cb-repo/P031-KAKAPO-20A/assets/kakapo-left.jpg

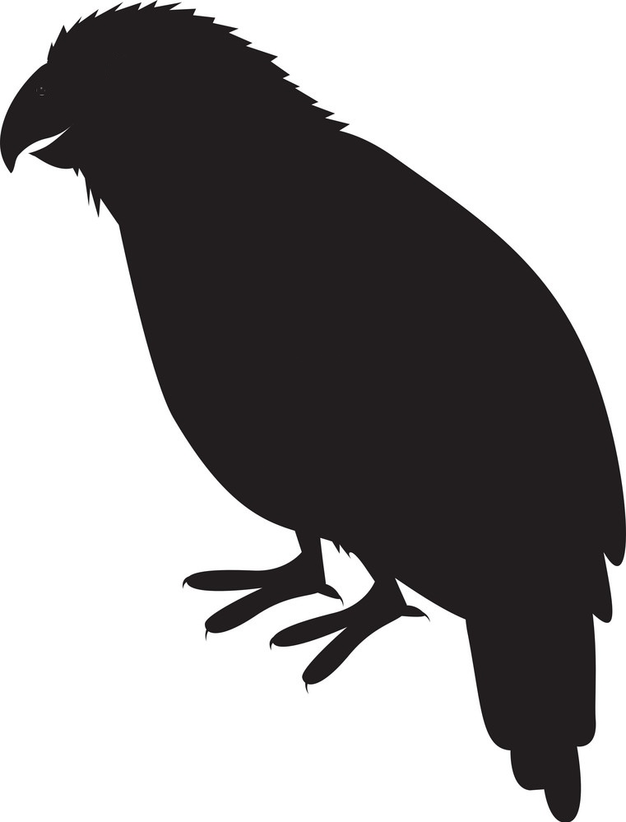
assets/kakapo-left.jpg
