cb-repo/P031-KAKAPO-20A/assets/kakapo-right.jpg

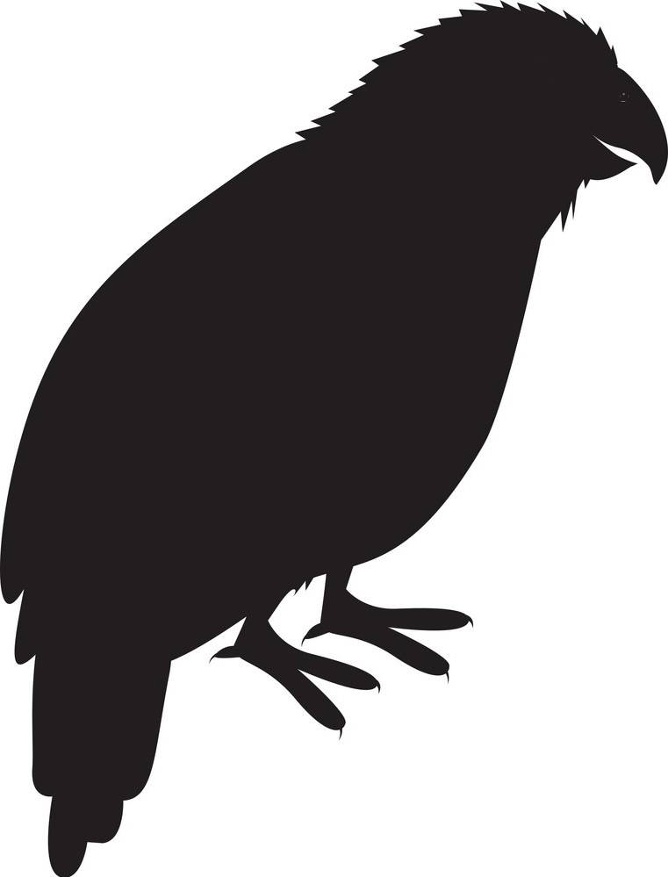
assets/kakapo-right.jpg
