cb-repo/P031-KAKAPO-20A/FIXTURE/KAKAPO-20A_FIXTURE.kicad_pcb

## KiCad design FIXTURE/KAKAPO-20A_FIXTURE.kicad_pcb (2025-01-29)

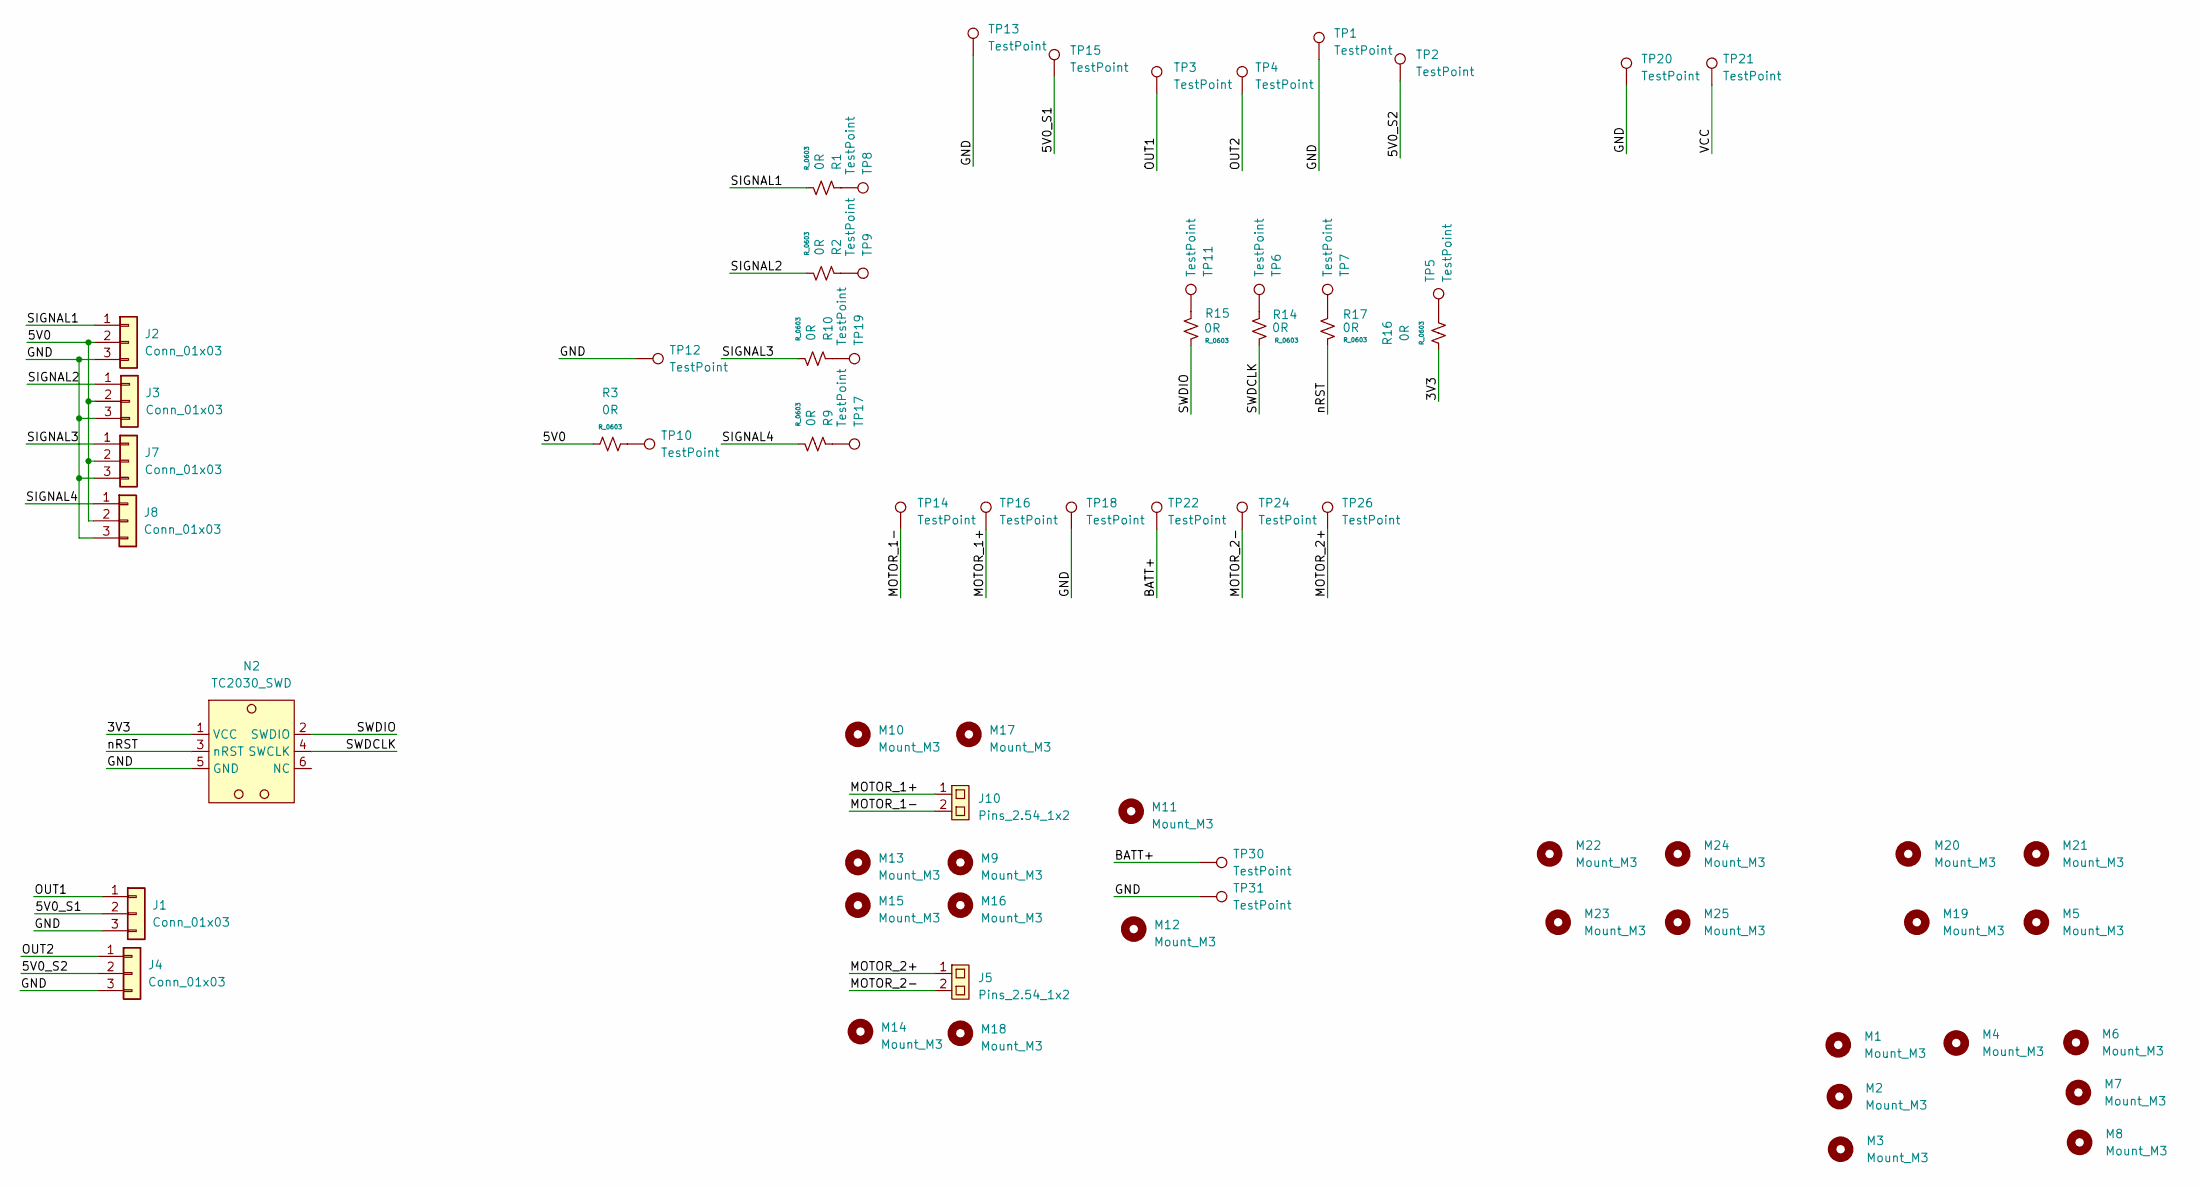
[picture p3: schematic KAKAPO-20A_FIXTURE.kicad_sch, KAKAPO - 20A FIXTURE]

Parts:
J1, J2, J3, J4, J7, J8: Conn_01x03; PinHeader_1x03_P2.54mm_Vertical
J5, J10: Pins_2.54_1x2; Pins-2.54-1x2
M1, M2, M3, M4, M5, M6, M7, M8, M9, M10, M11, M12, M13, M14, M15, M16, M17, M18, M19, M20, M21, M22, M23, M24, M25: Mount_M3
N2: TC2030_SWD; TagConnect_TC2030
R1, R2, R3, R9, R10, R14, R15, R16, R17: 0R; R_0603
TP1, TP2, TP3, TP4, TP5, TP6, TP7, TP8, TP9, TP10, TP11, TP12, TP13, TP14, TP15, TP16, TP17, TP18, TP19, TP20, TP21, TP22, TP24, TP26, TP30, TP31: TestPoint; TestPoint_THTPad_D3.0mm_Drill1.5mm

Connections:
/3V3: N2.1 (VCC), R16.1
/5V0: J2.2, J3.2, J7.2, J8.2, R3.1
/5V0_S1: J1.2, TP15.1
/5V0_S2: J4.2, TP2.1
/BATT+: TP22.1, TP30.1
/GND: J1.3, J2.3, J3.3, J4.3, J7.3, J8.3, N2.5 (GND), TP1.1, TP12.1, TP13.1, TP18.1, TP20.1, TP31.1
/MOTOR_1+: J10.1, TP16.1
/MOTOR_1-: J10.2, TP14.1
/MOTOR_2+: J5.1, TP26.1
/MOTOR_2-: J5.2, TP24.1
/OUT1: J1.1, TP3.1
/OUT2: J4.1, TP4.1
/SIGNAL1: J2.1, R1.2
/SIGNAL2: J3.1, R2.2
/SIGNAL3: J7.1, R10.2
/SIGNAL4: J8.1, R9.2
/SWDCLK: N2.4 (SWCLK), R14.2
/SWDIO: N2.2 (SWDIO), R15.2
/VCC: TP21.1
/nRST: N2.3 (nRST), R17.2
unnamed: R1.1, TP8.1
unnamed: R2.1, TP9.1
unnamed: R3.2, TP10.1
unnamed: R9.1, TP17.1
unnamed: R10.1, TP19.1
unnamed: R14.1, TP6.1
unnamed: R15.1, TP11.1
unnamed: R16.2, TP5.1
unnamed: R17.1, TP7.1

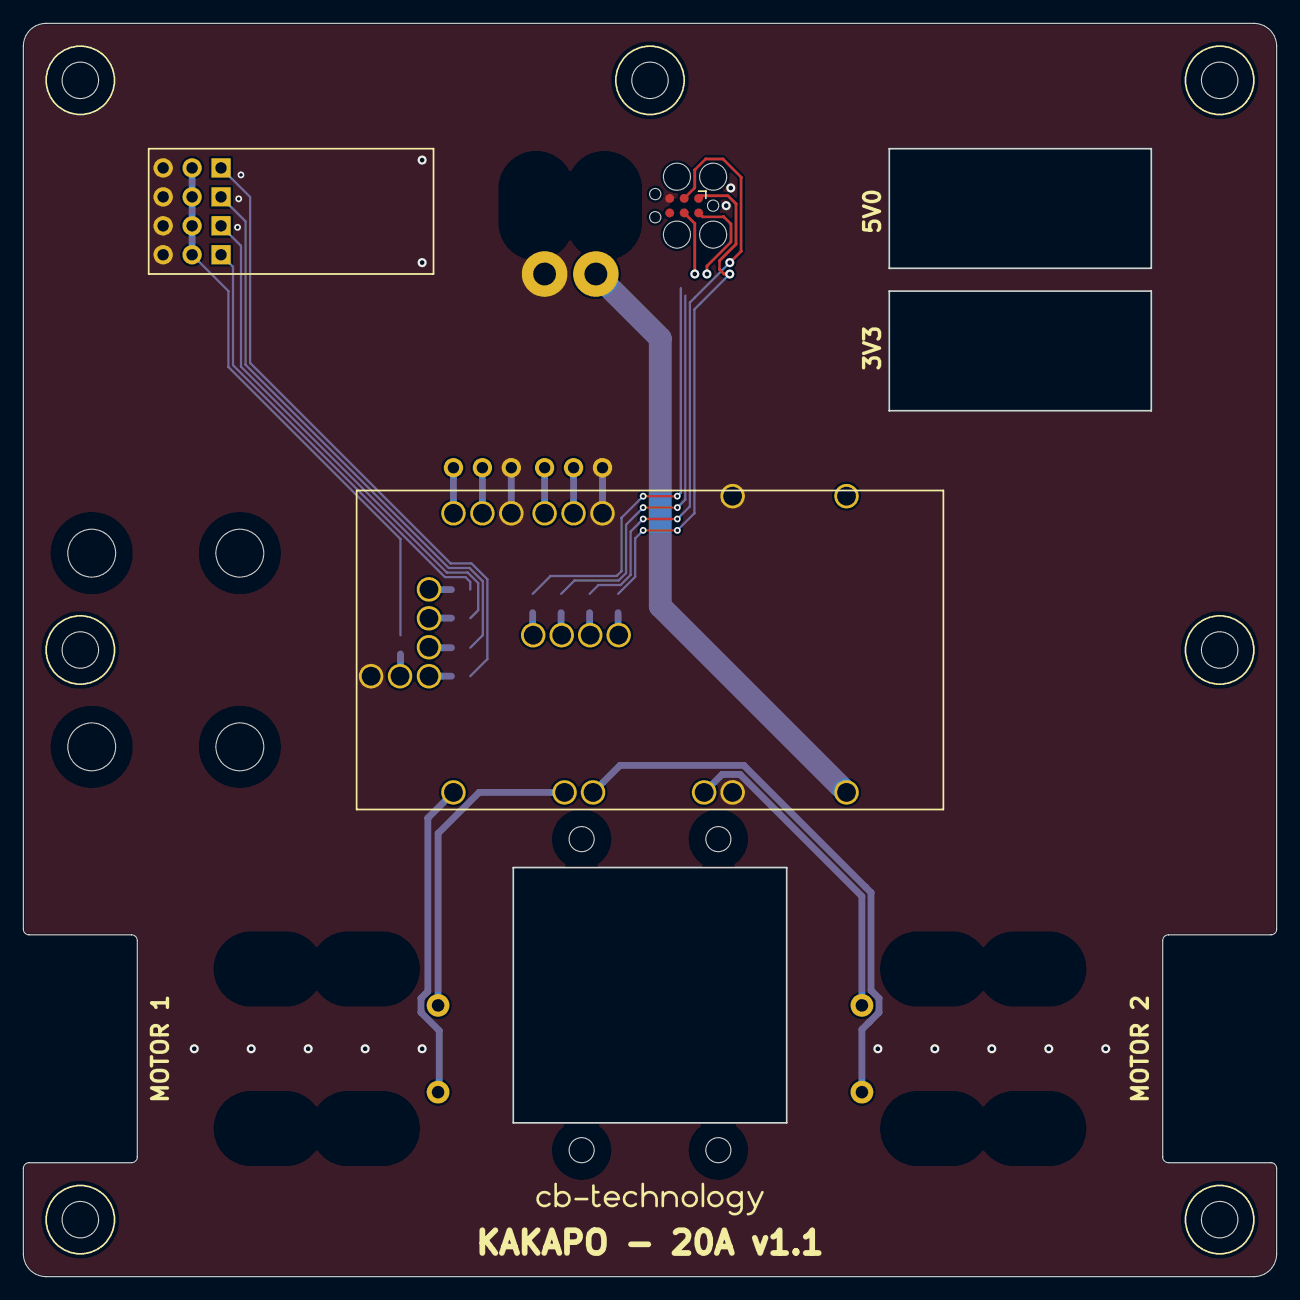
[picture p4: board KAKAPO-20A_FIXTURE.kicad_pcb from above]

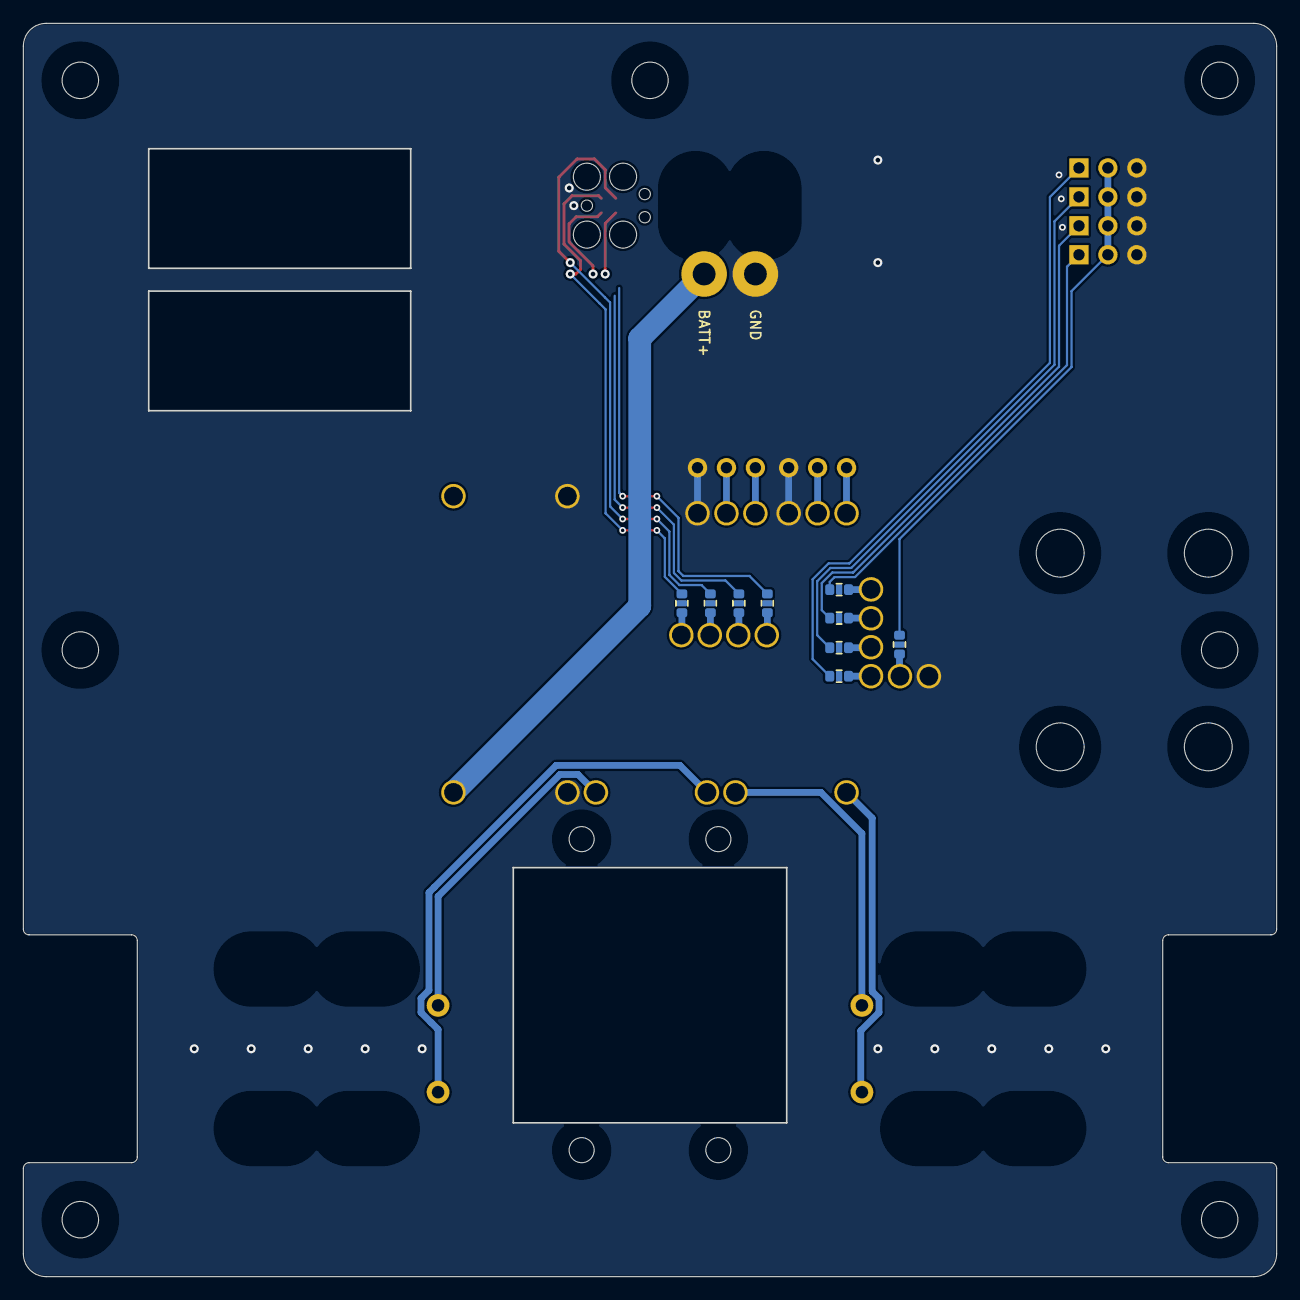
[picture p5: board KAKAPO-20A_FIXTURE.kicad_pcb from below]

Board: 2 copper layers, 110.0 x 110.0 mm, 69 parts (13 on the bottom side), 28 nets.
