cb-repo/P031-KAKAPO-20A/HW/KAKAPO-20A.kicad_pcb

## KiCad design HW/KAKAPO-20A.kicad_pcb (2024-07-17)

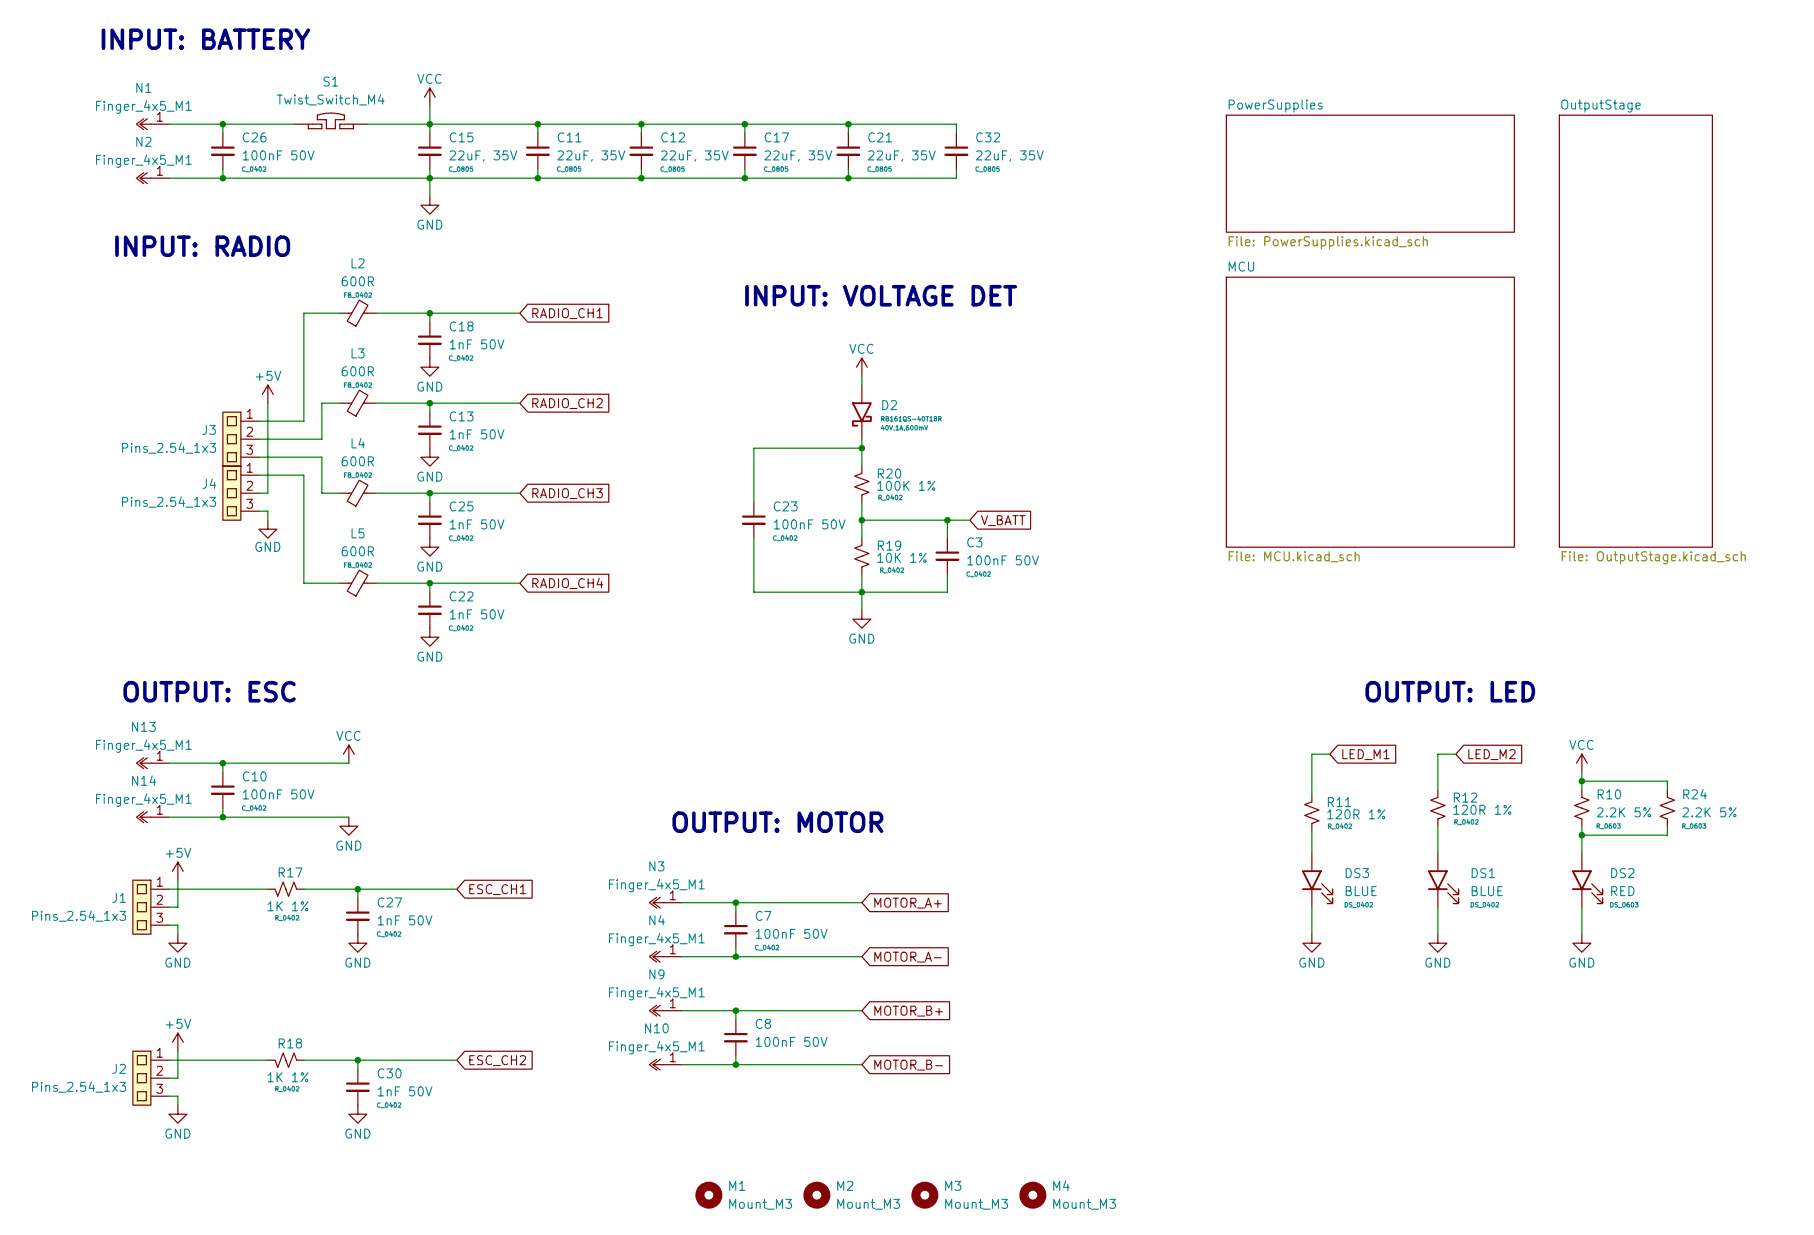
[picture p6: schematic KAKAPO-20A.kicad_sch, KAKAPO - 20A]

Parts:
C3, C7, C8, C10, C23, C26: 100nF 50V; C_0402; LCSC Part C105882
C11, C12, C15, C17, C21, C32: 22uF, 35V; C_0805; MFG Part HGC0805R5226M350NSLJ; LCSC Part C22367832
C13, C18, C22, C25, C27, C30: 1nF 50V; C_0402; LCSC Part C106205
D2: RB161QS-40T18R; R_0402; LCSC Part C2837790
DS1, DS3: BLUE; DS_0402; LCSC Part C965795
DS2: RED; DS_Everlight_IR21-21CL110TR8; MFG Part LTST-C230KRKT; LCSC Part C125107
J1, J2, J3, J4: Pins_2.54_1x3; Pins-2.54-1x3; LCSC Part C429954
L2, L3, L4, L5: 600R; FB_0402; MFG Part CBG100505U601T; LCSC Part C92618
M1, M2, M3, M4: Mount_M3
N1, N2, N3, N4, N9, N10, N13, N14: Finger_4x5_M1
R10, R24: 2.2K 5%; R_0603; MFG Part CRCW06032K20JNEAHP; LCSC Part C2077696
R11, R12: 120R 1%; R_0402; LCSC Part C114758
R17, R18: 1K 1%; R_0402; LCSC Part C2935237
R19: 10K 1%; R_0402; LCSC Part C60490
R20: 100K 1%; R_0402; LCSC Part C60491
S1: Twist_Switch_M4; MFG Part SMTSO4020MTJ; LCSC Part C2916373

Connections:
+5V: J1.2, J2.2, J4.2; also elsewhere on the board
ESC_CH1: C27.1, R17.2; also elsewhere on the board
ESC_CH2: C30.1, R18.2; also elsewhere on the board
GND: C3.2, C10.2, C11.2, C12.2, C13.2, C15.2, C17.2, C18.2, C21.2, C22.2, C23.2, C25.2, C26.2, C27.2, C30.2, C32.2, DS1.1 (K), DS2.1 (K), DS3.1 (K), J1.3, J2.3, J4.3, N2.1, N14.1, R19.2; also elsewhere on the board
LED_M1: R11.1; also elsewhere on the board
LED_M2: R12.1; also elsewhere on the board
MOTOR_A+: C7.1, N3.1; also elsewhere on the board
MOTOR_A-: C7.2, N4.1; also elsewhere on the board
MOTOR_B+: C8.1, N9.1; also elsewhere on the board
MOTOR_B-: C8.2, N10.1; also elsewhere on the board
unnamed: C23.1, D2.1, R20.1
unnamed: C26.1, N1.1, S1.2
unnamed: DS1.2 (A), R12.2
unnamed: DS2.2 (A), R10.2, R24.2
unnamed: DS3.2 (A), R11.2
unnamed: J1.1, R17.1
unnamed: J2.1, R18.1
unnamed: J3.1, L2.1
unnamed: J3.2, L3.1
unnamed: J3.3, L4.1
unnamed: J4.1, L5.1
RADIO_CH1: C18.1, L2.2; also elsewhere on the board
RADIO_CH2: C13.1, L3.2; also elsewhere on the board
RADIO_CH3: C25.1, L4.2; also elsewhere on the board
RADIO_CH4: C22.1, L5.2; also elsewhere on the board
VCC: C10.1, C11.1, C12.1, C15.1, C17.1, C21.1, C32.1, D2.2, N13.1, R10.1, R24.1, S1.1; also elsewhere on the board
V_BATT: C3.1, R19.1, R20.2; also elsewhere on the board

Notes on the sheet:
OUTPUT: MOTOR
OUTPUT: ESC
INPUT: RADIO
INPUT: VOLTAGE DET
OUTPUT: LED
INPUT: BATTERY

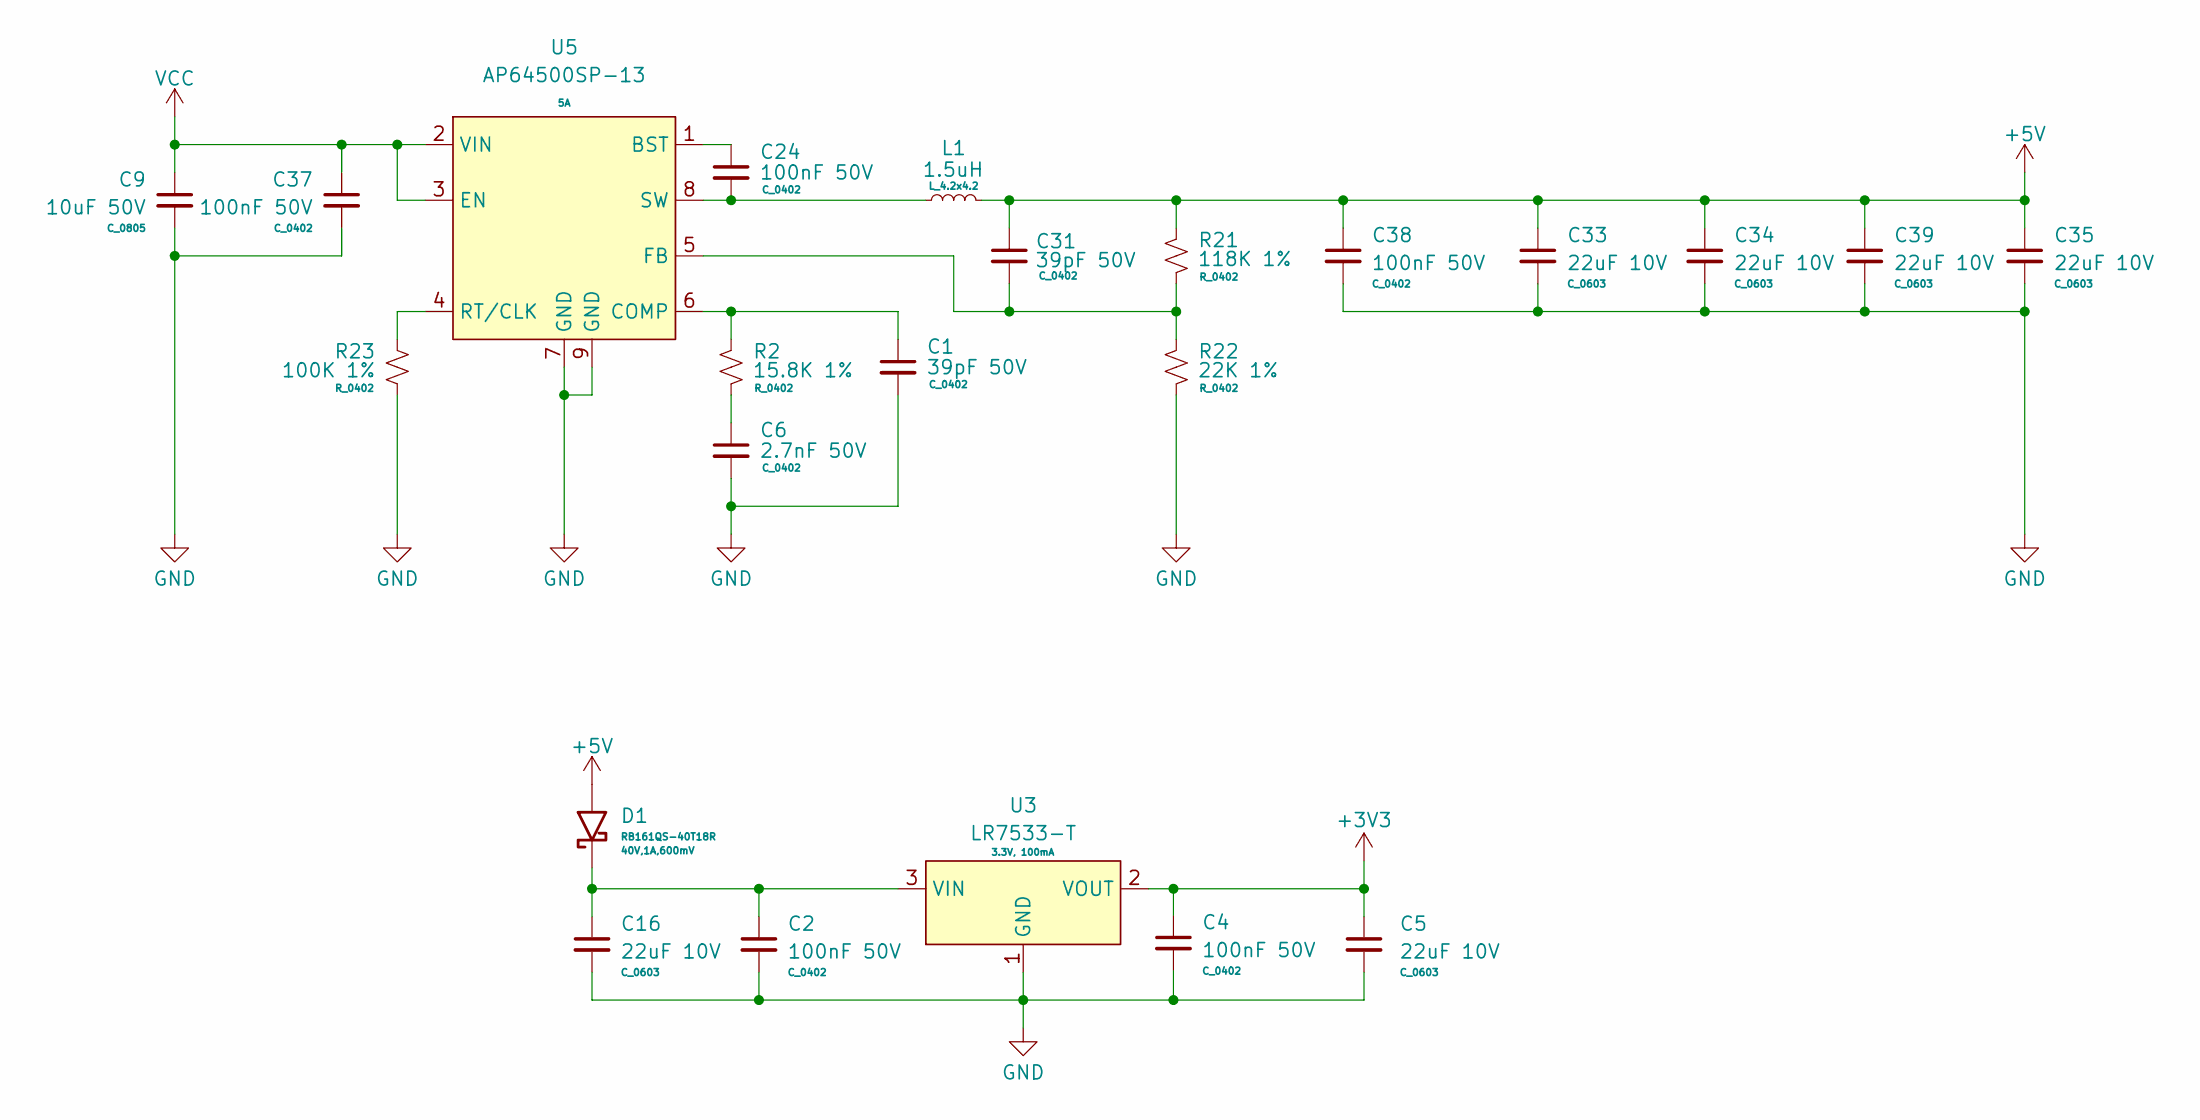
[picture p7: schematic PowerSupplies.kicad_sch, KAKAPO - 20A]

Parts:
C1, C31: 39pF 50V; C_0402; LCSC Part C106223
C2, C4, C24, C37, C38: 100nF 50V; C_0402; LCSC Part C105882
C5, C16, C33, C34, C35, C39: 22uF 10V; C_0603; LCSC Part C86295
C6: 2.7nF 50V; C_0402; LCSC Part C106251
C9: 10uF 50V; C_0805; MFG Part CL21A106KBYQNNE; LCSC Part C2932476
D1: RB161QS-40T18R; R_0402; LCSC Part C2837790
L1: 1.5uH; L_4.2x4.2; MFG Part BCIHP0420SC-1R5M; LCSC Part C2921165
R2: 15.8K 1%; R_0402; LCSC Part C26956
R21: 118K 1%; R_0402; LCSC Part C5126219
R22: 22K 1%; R_0402; LCSC Part C2909337
R23: 100K 1%; R_0402; LCSC Part C60491
U3: LR7533-T; SOT23_3; MFG Part LR7533-T; LCSC Part C486069
U5: AP64500SP-13; SOIC_8_EP; LCSC Part C2070920

Connections:
+3V3: C4.1, C5.1, U3.2 (VOUT); also elsewhere on the board
+5V: C31.1, C33.1, C34.1, C35.1, C38.1, C39.1, D1.2, L1.2, R21.1; also elsewhere on the board
GND: C1.2, C2.2, C4.2, C5.2, C6.2, C9.2, C16.2, C33.2, C34.2, C35.2, C37.2, C38.2, C39.2, R22.2, R23.2, U3.1 (GND), U5.7 (GND), U5.9 (GND); also elsewhere on the board
unnamed: C6.1, R2.2
unnamed: C2.1, C16.1, D1.1, U3.3 (VIN)
unnamed: C24.1, U5.1 (BST)
unnamed: C1.1, R2.1, U5.6 (COMP)
unnamed: C31.2, R21.2, R22.1, U5.5 (FB)
unnamed: R23.1, U5.4 (RT/CLK)
unnamed: C24.2, L1.1, U5.8 (SW)
VCC: C9.1, C37.1, U5.2 (VIN), U5.3 (EN); also elsewhere on the board

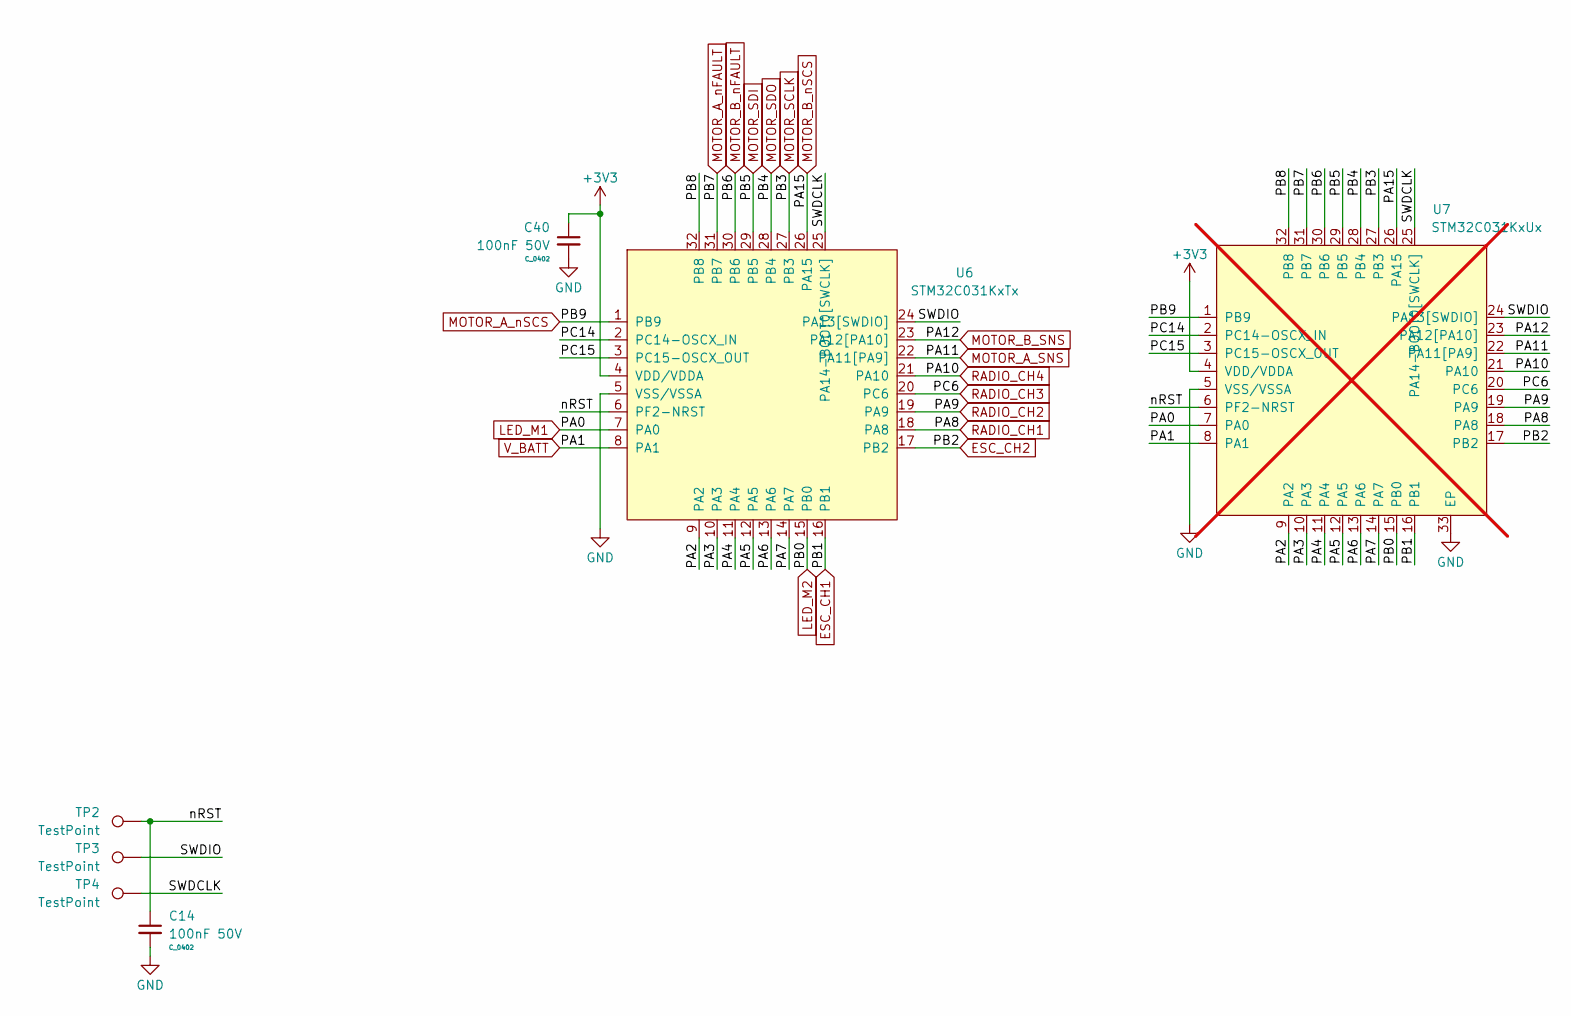
[picture p8: schematic MCU.kicad_sch, KAKAPO - 20A]

Parts:
C14, C40: 100nF 50V; C_0402; LCSC Part C105882
TP2, TP3, TP4: TestPoint; TestPoint_Pad_D1.5mm
U6: STM32C031KxTx; LQFP32_08_7x7
U7: STM32C031KxUx; QFN32_05_5x5_EP; not fitted

Connections:
+3V3: C40.1, U6.4 (VDD/VDDA), U7.4 (VDD/VDDA); also elsewhere on the board
/MCU/PA2: U6.9 (PA2), U7.9 (PA2)
/MCU/PA3: U6.10 (PA3), U7.10 (PA3)
/MCU/PA4: U6.11 (PA4), U7.11 (PA4)
/MCU/PA5: U6.12 (PA5), U7.12 (PA5)
/MCU/PA6: U6.13 (PA6), U7.13 (PA6)
/MCU/PA7: U6.14 (PA7), U7.14 (PA7)
/MCU/PB8: U6.32 (PB8), U7.32 (PB8)
/MCU/PC14: U6.2 (PC14-OSCX_IN), U7.2 (PC14-OSCX_IN)
/MCU/PC15: U6.3 (PC15-OSCX_OUT), U7.3 (PC15-OSCX_OUT)
/MCU/SWDCLK: TP4.1, U6.25 (PA14-BOOT0[SWCLK]), U7.25 (PA14-BOOT0[SWCLK])
/MCU/SWDIO: TP3.1, U6.24 (PA13[SWDIO]), U7.24 (PA13[SWDIO])
/MCU/nRST: C14.1, TP2.1, U6.6 (PF2-NRST), U7.6 (PF2-NRST)
ESC_CH1: U6.16 (PB1), U7.16 (PB1); also elsewhere on the board
ESC_CH2: U6.17 (PB2), U7.17 (PB2); also elsewhere on the board
GND: C14.2, C40.2, U6.5 (VSS/VSSA), U7.5 (VSS/VSSA), U7.33 (EP); also elsewhere on the board
LED_M1: U6.7 (PA0), U7.7 (PA0); also elsewhere on the board
LED_M2: U6.15 (PB0), U7.15 (PB0); also elsewhere on the board
MOTOR_A_SNS: U6.22 (PA11[PA9]), U7.22 (PA11[PA9]); also elsewhere on the board
MOTOR_A_nFAULT: U6.31 (PB7), U7.31 (PB7); also elsewhere on the board
MOTOR_A_nSCS: U6.1 (PB9), U7.1 (PB9); also elsewhere on the board
MOTOR_B_SNS: U6.23 (PA12[PA10]), U7.23 (PA12[PA10]); also elsewhere on the board
MOTOR_B_nFAULT: U6.30 (PB6), U7.30 (PB6); also elsewhere on the board
MOTOR_B_nSCS: U6.26 (PA15), U7.26 (PA15); also elsewhere on the board
MOTOR_SCLK: U6.27 (PB3), U7.27 (PB3); also elsewhere on the board
MOTOR_SDI: U6.29 (PB5), U7.29 (PB5); also elsewhere on the board
MOTOR_SDO: U6.28 (PB4), U7.28 (PB4); also elsewhere on the board
RADIO_CH1: U6.18 (PA8), U7.18 (PA8); also elsewhere on the board
RADIO_CH2: U6.19 (PA9), U7.19 (PA9); also elsewhere on the board
RADIO_CH3: U6.20 (PC6), U7.20 (PC6); also elsewhere on the board
RADIO_CH4: U6.21 (PA10), U7.21 (PA10); also elsewhere on the board
V_BATT: U6.8 (PA1), U7.8 (PA1); also elsewhere on the board

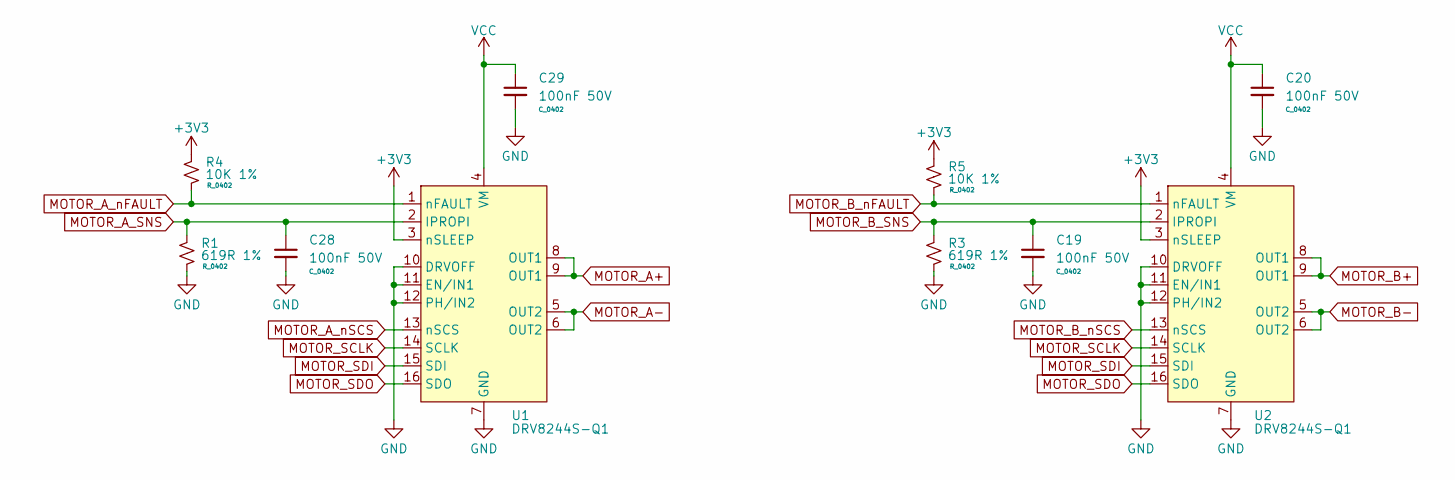
[picture p9: schematic OutputStage.kicad_sch, KAKAPO - 20A]

Parts:
C19, C20, C28, C29: 100nF 50V; C_0402; LCSC Part C105882
R1, R3: 619R 1%; R_0402; LCSC Part C5121525
R4, R5: 10K 1%; R_0402; LCSC Part C60490
U1, U2: DRV8244S-Q1; VQFN-HR-16; LCSC Part C3681071

Connections:
+3V3: R4.1, R5.1, U1.3 (nSLEEP), U2.3 (nSLEEP); also elsewhere on the board
GND: C19.2, C20.2, C28.2, C29.2, R1.2, R3.2, U1.7 (GND), U1.10 (DRVOFF), U1.11 (EN/IN1), U1.12 (PH/IN2), U2.7 (GND), U2.10 (DRVOFF), U2.11 (EN/IN1), U2.12 (PH/IN2); also elsewhere on the board
MOTOR_A+: U1.8 (OUT1), U1.9 (OUT1); also elsewhere on the board
MOTOR_A-: U1.5 (OUT2), U1.6 (OUT2); also elsewhere on the board
MOTOR_A_SNS: C28.1, R1.1, U1.2 (IPROPI); also elsewhere on the board
MOTOR_A_nFAULT: R4.2, U1.1 (nFAULT); also elsewhere on the board
MOTOR_A_nSCS: U1.13 (nSCS); also elsewhere on the board
MOTOR_B+: U2.8 (OUT1), U2.9 (OUT1); also elsewhere on the board
MOTOR_B-: U2.5 (OUT2), U2.6 (OUT2); also elsewhere on the board
MOTOR_B_SNS: C19.1, R3.1, U2.2 (IPROPI); also elsewhere on the board
MOTOR_B_nFAULT: R5.2, U2.1 (nFAULT); also elsewhere on the board
MOTOR_B_nSCS: U2.13 (nSCS); also elsewhere on the board
MOTOR_SCLK: U1.14 (SCLK), U2.14 (SCLK); also elsewhere on the board
MOTOR_SDI: U1.15 (SDI), U2.15 (SDI); also elsewhere on the board
MOTOR_SDO: U1.16 (SDO), U2.16 (SDO); also elsewhere on the board
VCC: C20.1, C29.1, U1.4 (VM), U2.4 (VM); also elsewhere on the board

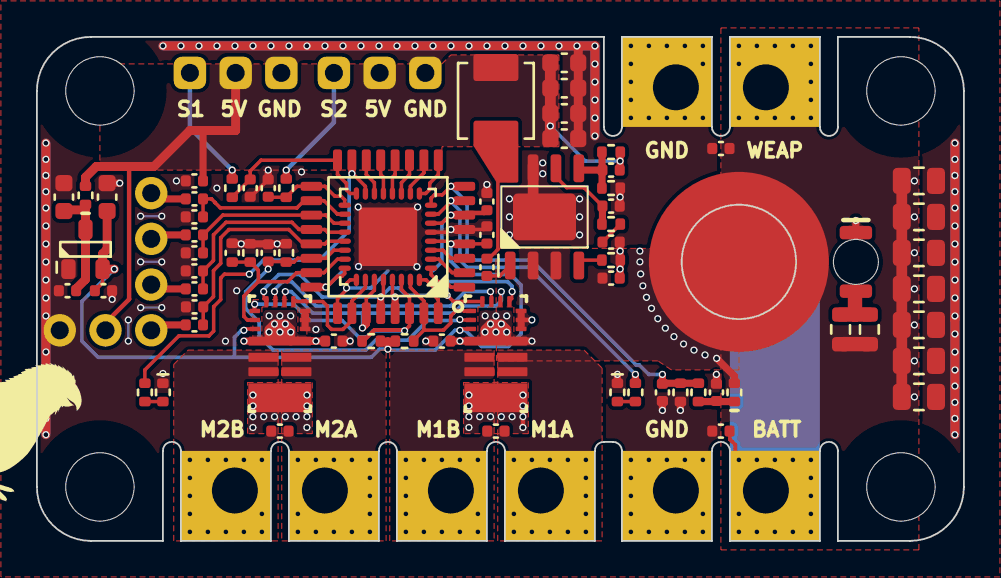
[picture p10: board KAKAPO-20A.kicad_pcb from above]

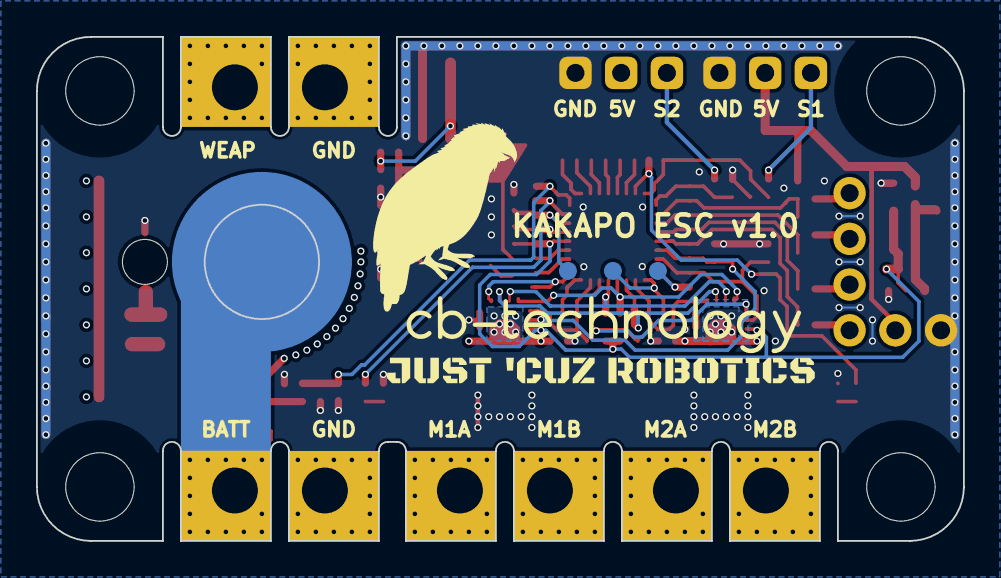
[picture p11: board KAKAPO-20A.kicad_pcb from below]

Board: 4 copper layers, 51.5 x 28.0 mm, 91 parts (7 on the bottom side), 56 nets.
