cb-repo/P031-KAKAPO-20A/FW/KAKAPO-20A/Core/Inc/Servo.h

/* ~~~~~~~~~~~~~~~~~~~~~~~~~~~~~~~~~~~~~~~~~~~~~~~~~~~~ */
#ifndef SERVO_H
#define SERVO_H
/* ~~~~~~~~~~~~~~~~~~~~~~~~~~~~~~~~~~~~~~~~~~~~~~~~~~~~ */


#include "STM32X.h"
#include "GPIO.h"
#include "TIM.h"

#include "main.h"
#include "Battery.h"
#include "Temperature.h"
#include "Radio.h"


/* ~~~~~~~~~~~~~~~~~~~~~~~~~~~~~~~~~~~~~~~~~~~~~~~~~~~~ */
/* PUBLIC DEFINITIONS									*/
/* ~~~~~~~~~~~~~~~~~~~~~~~~~~~~~~~~~~~~~~~~~~~~~~~~~~~~ */


#define SERVO_CH_PERIOD		20
#define SERVO_CH_MIN		1000
#define SERVO_CH_CENTER		1500
#define SERVO_CH_MAX		2000

#define SERVO_CH_FULLSCALE	SERVO_MAX-SERVO_MIN
#define SERVO_CH_HALFSCALE	SERVO_MAX-SERVO_CENTER


/* ~~~~~~~~~~~~~~~~~~~~~~~~~~~~~~~~~~~~~~~~~~~~~~~~~~~~ */
/* PUBLIC TYPES      									*/
/* ~~~~~~~~~~~~~~~~~~~~~~~~~~~~~~~~~~~~~~~~~~~~~~~~~~~~ */

/* ~~~~~~~~~~~~~~~~~~~~~~~~~~~~~~~~~~~~~~~~~~~~~~~~~~~~ */
/* PUBLIC FUNCTIONS										*/
/* ~~~~~~~~~~~~~~~~~~~~~~~~~~~~~~~~~~~~~~~~~~~~~~~~~~~~ */


void SERVO_Init			( void );
void SERVO_Deinit		( void );
void SERVO_Update		( void );
void SERVO_getConfig	( void );


/* ~~~~~~~~~~~~~~~~~~~~~~~~~~~~~~~~~~~~~~~~~~~~~~~~~~~~ */
/* EXTERN DECLARATIONS									*/
/* ~~~~~~~~~~~~~~~~~~~~~~~~~~~~~~~~~~~~~~~~~~~~~~~~~~~~ */

/* ~~~~~~~~~~~~~~~~~~~~~~~~~~~~~~~~~~~~~~~~~~~~~~~~~~~~ */
#endif /* SERVO_H */
/* ~~~~~~~~~~~~~~~~~~~~~~~~~~~~~~~~~~~~~~~~~~~~~~~~~~~~ */
