cb-repo/P031-KAKAPO-20A/(commit log)

2024-02-29 Copy in WEKA-20A v2.0 HW as a starting point
    [MCU.kicad_sch, OutputStage.kicad_sch, PowerSupplies.kicad_sch, WEKA_ESC-20A.kicad_pcb, WEKA_ESC-20A.kicad_sch, WEKA_ESC-20A_FIXTURE-BASE.kicad_pcb, WEKA_ESC-20A_FIXTURE.kicad_pcb, WEKA_ESC-20A_FIXTURE.kicad_sch]
2024-03-10 WIP - Layout XT30/PCB Finger Positions
    [KAKAPO_ESC-20A.kicad_pcb, KAKAPO_ESC-20A.kicad_sch, MCU.kicad_sch, OutputStage.kicad_sch, PowerSupplies.kicad_sch, WEKA_ESC-20A.kicad_pcb, bom.csv, designators.csv]
2024-03-14 WIP - Layout Motor Drivers + Buck Circuit
    [KAKAPO_ESC-20A.kicad_pcb, KAKAPO_ESC-20A.kicad_sch, MCU.kicad_sch, OutputStage.kicad_sch, PowerSupplies.kicad_sch]
2024-03-15 WIP - Continue Tracking MCU
    [KAKAPO_ESC-20A.kicad_pcb, KAKAPO_ESC-20A.kicad_sch]
2024-04-11 WIP - Final Detail Design Before Design Review
    [KAKAPO_ESC-20A.kicad_pcb, KAKAPO_ESC-20A.kicad_sch, MCU.kicad_sch]
2024-04-19 Update .gitignore to remove KiCAD backup files
2024-04-24 Move 5V Supply Around To Make More Efficient Conduction Path
    [KAKAPO_ESC-20A.kicad_pcb, KAKAPO_ESC-20A.kicad_sch, MCU.kicad_sch]
2024-04-27 Finish Tracking and Release For MFG
    [KAKAPO-20A.kicad_pcb, KAKAPO-20A.kicad_sch, KAKAPO_ESC-20A.kicad_pcb, MCU.kicad_sch, OutputStage.kicad_sch, PowerSupplies.kicad_sch, bom.csv, designators.csv]
2024-04-28 Update Part Numbers For Second Release
    [KAKAPO-20A.kicad_pcb, KAKAPO-20A.kicad_sch, MCU.kicad_sch, OutputStage.kicad_sch, PowerSupplies.kicad_sch, bom.csv, designators.csv, positions.csv]
2024-06-04 Remove WEKA Production Files
    [WEKA_ESC-20A_FIXTURE-BASE.kicad_pcb, WEKA_ESC-20A_FIXTURE.kicad_pcb, WEKA_ESC-20A_FIXTURE.kicad_sch, bom.csv, designators.csv, positions.csv]
2024-06-04 Update gitignore
    [PowerSupplies.kicad_sch]
2024-06-15 Update Switch NPTH Geometry and VBatt Circuit
    [KAKAPO-20A.kicad_pcb, KAKAPO-20A.kicad_sch, MCU.kicad_sch, OutputStage.kicad_sch, PowerSupplies.kicad_sch]
2024-06-16 Fix Motor Driver Comms Tracking Issue
    [KAKAPO-20A.kicad_pcb, PowerSupplies.kicad_sch]
2024-06-16 Update LED to Visible Wavelength
    [KAKAPO-20A.kicad_pcb, KAKAPO-20A.kicad_sch]
2024-06-17 Create Fixture PCB
    [KAKAPO-20A_FIXTURE.kicad_pcb, KAKAPO-20A_FIXTURE.kicad_sch, bom.csv, designators.csv, positions.csv]
2024-07-09 Create v1.0 Fixed From v0.2 HW
    [KAKAPO-20A.kicad_pcb, KAKAPO-20A.kicad_sch, MCU.kicad_sch, OutputStage.kicad_sch, PowerSupplies.kicad_sch, bom.csv, designators.csv, positions.csv]
2024-07-17 WIP FW Commit - Debugging SPI Non-Functionalty
    [KAKAPO-20A.kicad_pcb]
2024-07-19 Get Motor Output Working and Implement Servo Outputs
2024-07-21 Resolve 12V output restriction for Junkyard
    [Motor.c]
2025-01-29 Extend Calibration Timeout For Usability
2025-01-29 Update Fixture Design to Be Inline With Other Jigs
    [KAKAPO-20A_FIXTURE.kicad_pcb, KAKAPO-20A_FIXTURE.kicad_sch, bom.csv, designators.csv, positions.csv]
